robotronik/cdfr2023-base-roulante-carte-asservissment/Asservissement_CDFR_2023/Asservissement_CDFR_2023.kicad_pcb

## KiCad design Asservissement_CDFR_2023/Asservissement_CDFR_2023.kicad_pcb (2025-02-03)

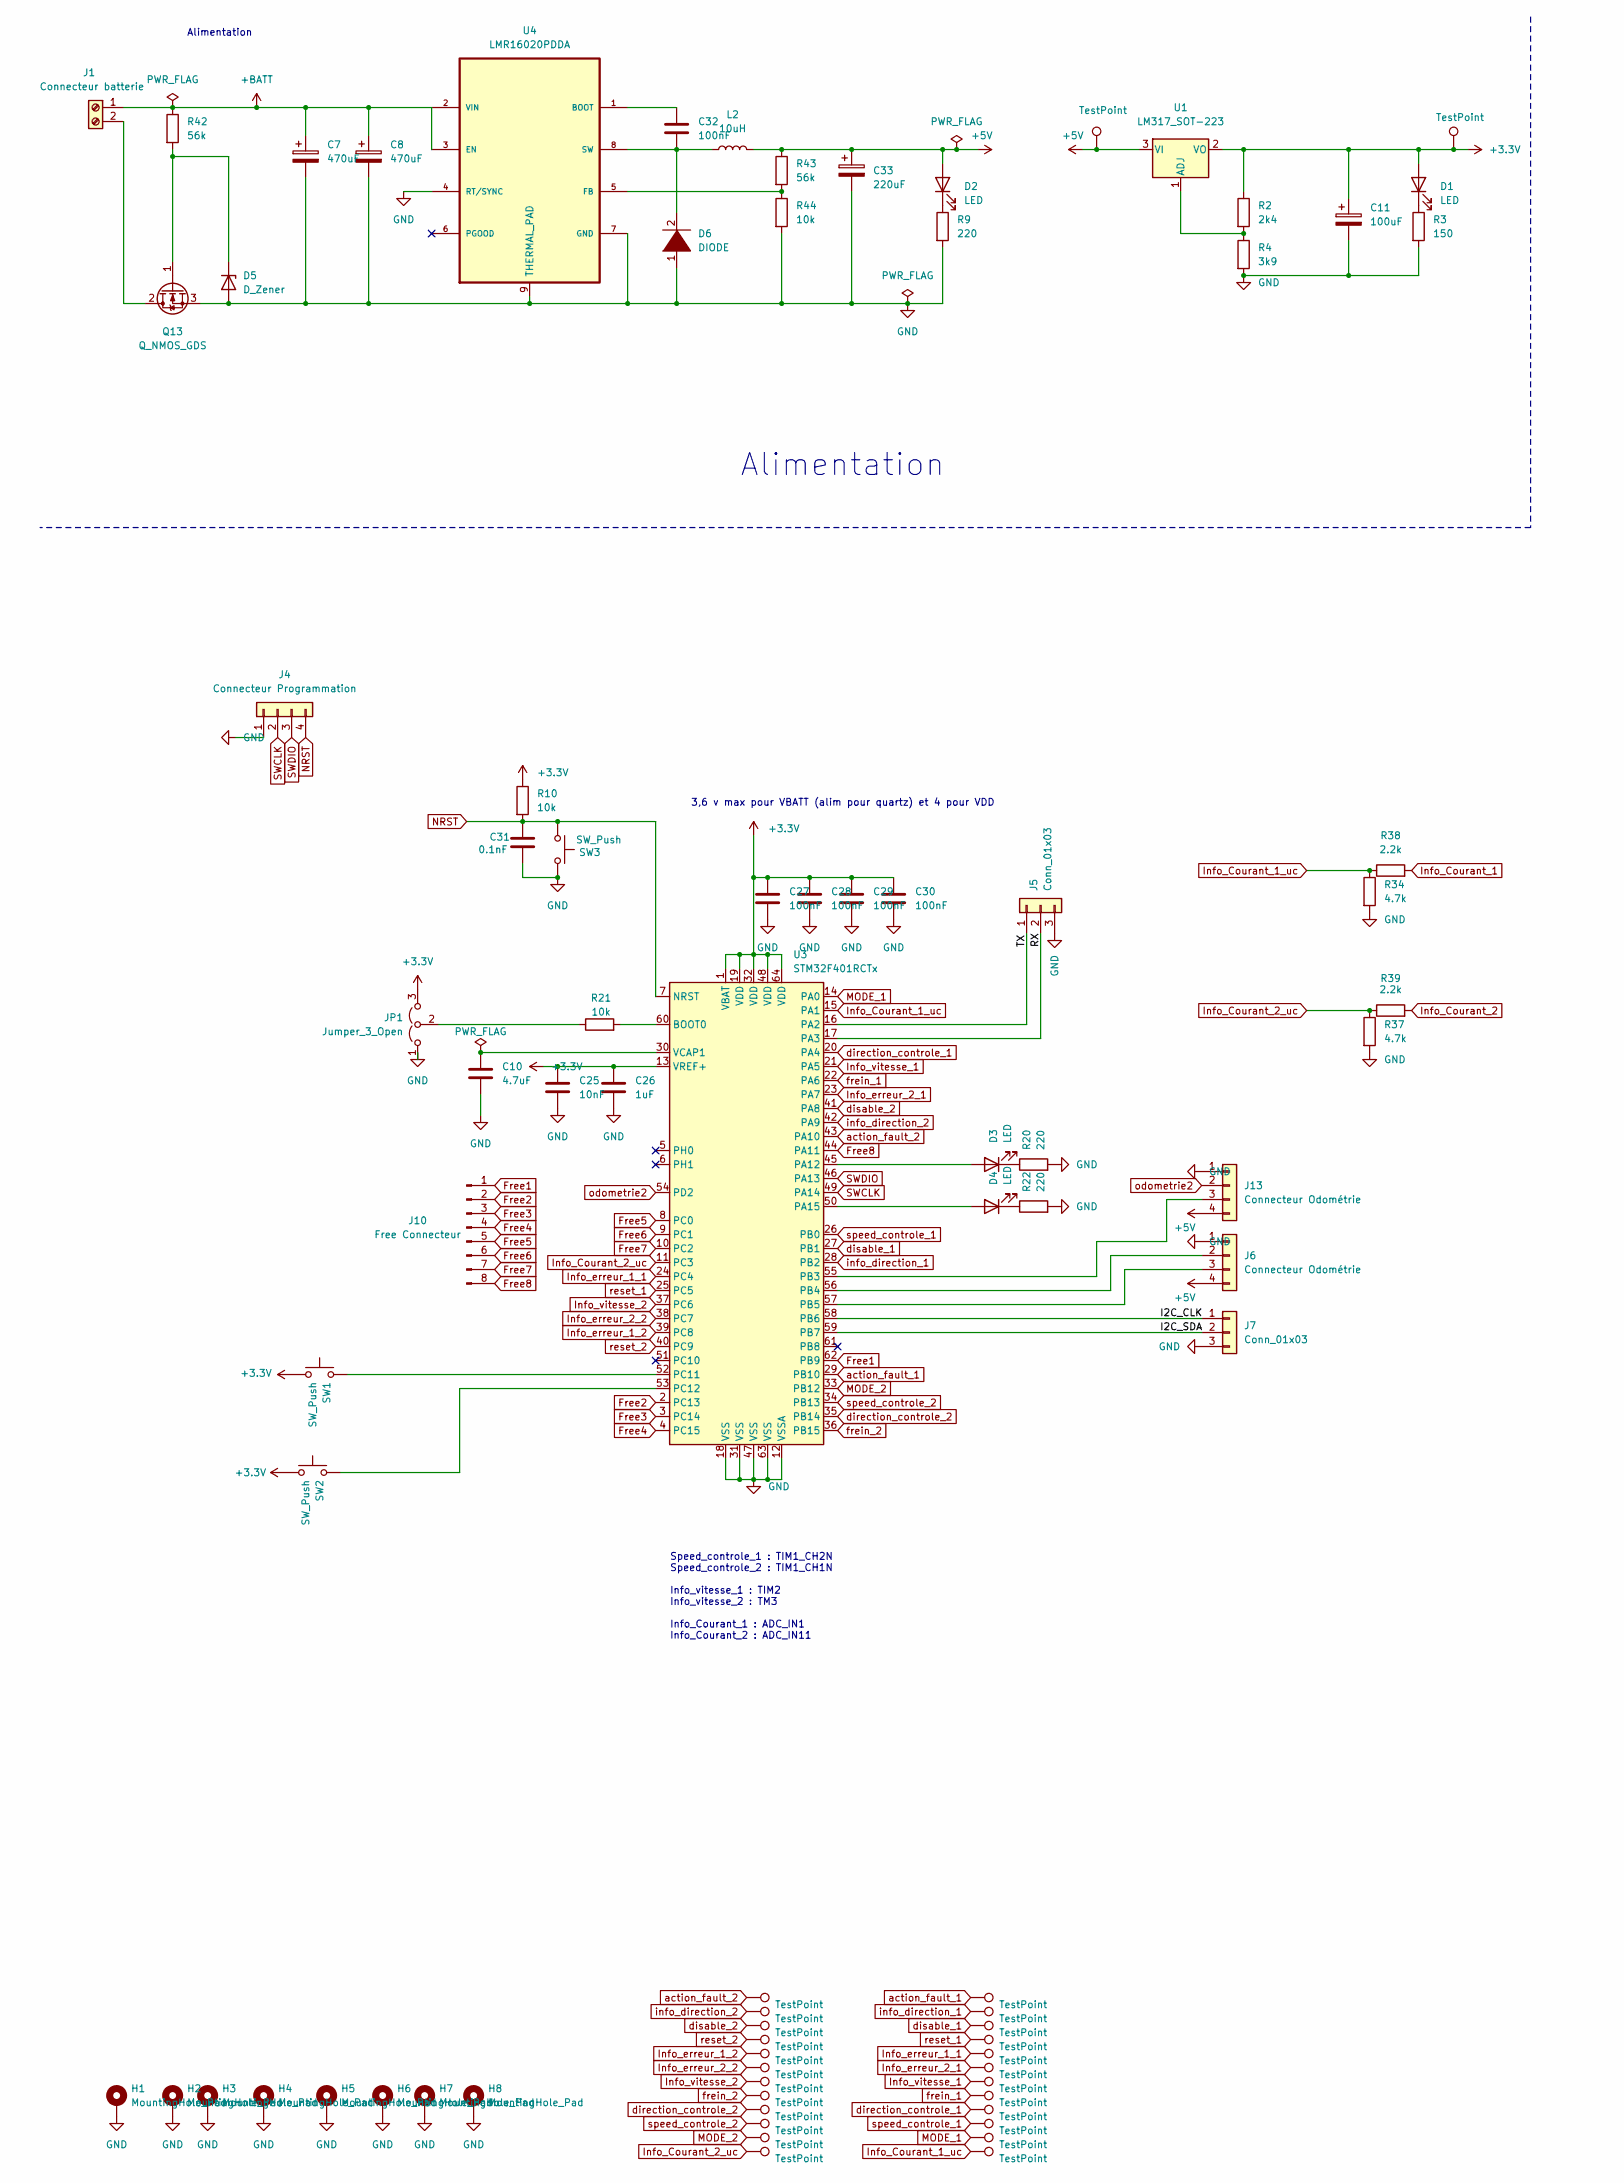
[picture p1: schematic Asservissement_CDFR_2023.kicad_sch, part in row 1, column 1]

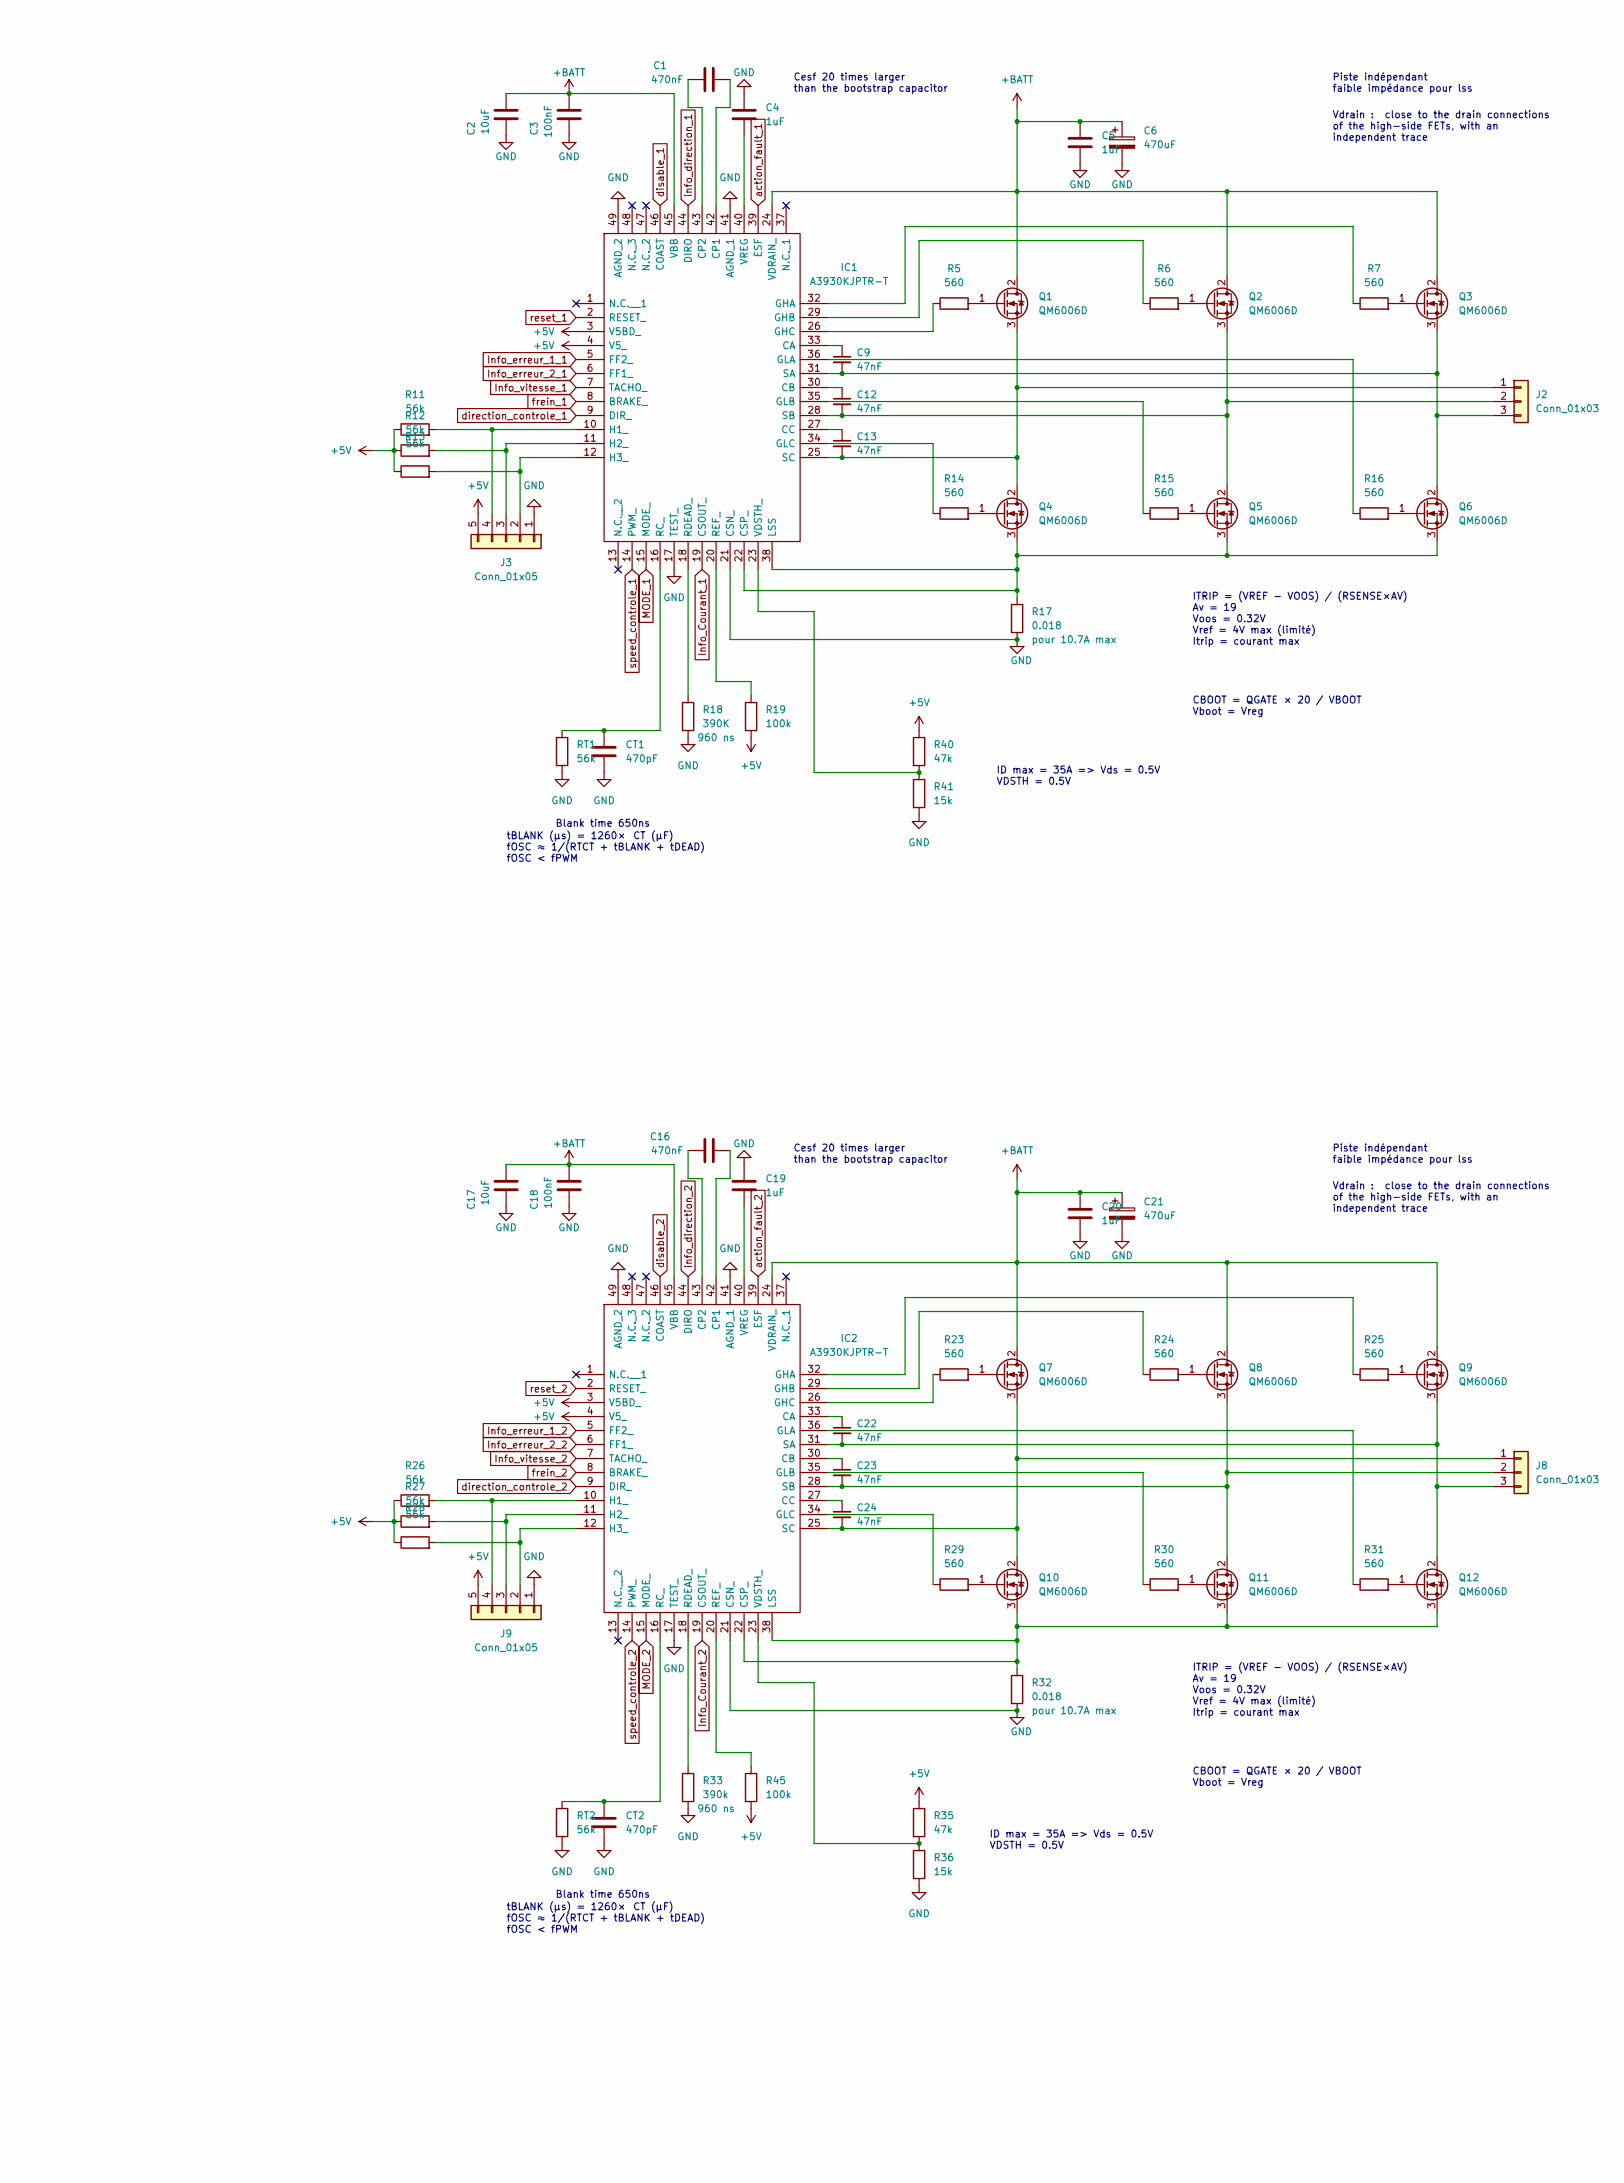
[picture p2: schematic Asservissement_CDFR_2023.kicad_sch, part in row 1, column 2]

Parts:
C1, C16: 470nF; C_0805_2012Metric_Pad1.18x1.45mm_HandSolder
C2, C17: 10uF; C_0805_2012Metric_Pad1.18x1.45mm_HandSolder
C3, C18, C27, C28, C29, C30, C32: 100nF; C_0805_2012Metric_Pad1.18x1.45mm_HandSolder
C4, C5, C19, C20, C26: 1uF; C_0805_2012Metric_Pad1.18x1.45mm_HandSolder
C6, C7, C8, C21: 470uF; CP_Elec_10x10.5
C9, C12, C13, C22, C23, C24: 47nF; C_0805_2012Metric_Pad1.18x1.45mm_HandSolder
C10: 4.7uF; C_0805_2012Metric_Pad1.18x1.45mm_HandSolder
C11: 100uF; CP_Elec_10x10.5
C25: 10nF; C_0805_2012Metric_Pad1.18x1.45mm_HandSolder
C31: 0.1nF; C_0805_2012Metric_Pad1.18x1.45mm_HandSolder
C33: 220uF; CP_Elec_10x10.5
CT1, CT2: 470pF; C_0805_2012Metric_Pad1.18x1.45mm_HandSolder
D1, D2, D3, D4: LED; LED_0805_2012Metric_Pad1.15x1.40mm_HandSolder
D5: D_Zener; D_SOD-123
D6: DIODE; DIOM505270X240
H1, H2, H3, H4: MountingHole_Pad; MountingHole_3.2mm_M3_Pad_Via
H5, H6, H7, H8: MountingHole_Pad; MountingHole_2.7mm_Pad_Via
IC1, IC2: A3930KJPTR-T; A3930KJPTRT; Manufacturer_Part_Number A3930KJPTR-T
J1: Connecteur batterie; CUI_TBP01R1-508-02BE
J2, J8: Conn_01x03; CUI_TBP02R1-381-03BE
J3, J9: Conn_01x05; JST_XH_B5B-XH-A_1x05_P2.50mm_Vertical
J4: Connecteur Programmation; PinHeader_1x04_P2.54mm_Vertical
J5: Conn_01x03; PinHeader_1x03_P2.54mm_Vertical
J6, J13: Connecteur Odométrie; JST_XH_B4B-XH-A_1x04_P2.50mm_Vertical
J7: Conn_01x03; JST_XH_B3B-XH-A_1x03_P2.50mm_Vertical
J10: Free Connecteur; PinHeader_1x08_P2.54mm_Vertical
JP1: Jumper_3_Open; PinHeader_1x03_P2.54mm_Vertical
L2: 10uH; IND_IHLP_2525_CZ-M
Q1, Q2, Q3, Q4, Q5, Q6, Q7, Q8, Q9, Q10, Q11, Q12: QM6006D; TO-252-2
Q13: Q_NMOS_GDS; TO-252-2
R2: 2k4; R_0805_2012Metric_Pad1.20x1.40mm_HandSolder
R3: 150; R_0805_2012Metric_Pad1.20x1.40mm_HandSolder
R4: 3k9; R_0805_2012Metric_Pad1.20x1.40mm_HandSolder
R5, R6, R7, R14, R15, R16, R23, R24, R25, R29, R30, R31: 560; R_0805_2012Metric_Pad1.20x1.40mm_HandSolder
R9, R20, R22: 220; R_0805_2012Metric_Pad1.20x1.40mm_HandSolder
R10, R21, R44: 10k; R_0805_2012Metric_Pad1.20x1.40mm_HandSolder
R11, R12, R13, R26, R27, R28, R42, R43: 56k; R_0805_2012Metric_Pad1.20x1.40mm_HandSolder
R17, R32: 0.018; R_2512_6332Metric
R18: 390K; R_0805_2012Metric_Pad1.20x1.40mm_HandSolder
R19, R45: 100k; R_0805_2012Metric_Pad1.20x1.40mm_HandSolder
R33: 390k; R_0805_2012Metric_Pad1.20x1.40mm_HandSolder
R34, R37: 4.7k; R_0805_2012Metric_Pad1.20x1.40mm_HandSolder
R35, R40: 47k; R_0805_2012Metric_Pad1.20x1.40mm_HandSolder
R36, R41: 15k; R_0805_2012Metric_Pad1.20x1.40mm_HandSolder
R38, R39: 2.2k; R_0805_2012Metric_Pad1.20x1.40mm_HandSolder
RT1, RT2: 56k; R_0805_2012Metric_Pad1.20x1.40mm_HandSolder
SW1, SW2, SW3: SW_Push; SW_PUSH_6mm_H5mm
TP1, TP2, TP3, TP4, TP5, TP6, TP7, TP8, TP9, TP10, TP11, TP12, TP13, TP14, TP25, TP26, TP27, TP28, TP29, TP30, TP31, TP32, TP33, TP34, TP35, TP36: TestPoint; TestPoint_Pad_D1.0mm
U1: LM317_SOT-223; SOT-223-3_TabPin2
U3: STM32F401RCTx; LQFP-64_10x10mm_P0.5mm
U4: LMR16020PDDA; SOIC-8-1EP_3.9x4.9mm_P1.27mm_EP2.41x3.3mm

Connections:
+3.3V: C11.1, C25.1, C26.1, C27.1, C28.1, C29.1, C30.1, D1.2 (A), JP1.3 (B), R2.1, R10.1, SW1.1, SW2.1, TP14.1, U1.2 (VO), U3.1 (VBAT), U3.13 (VREF+), U3.19 (VDD), U3.32 (VDD), U3.48 (VDD), U3.64 (VDD)
+5V: C33.1, D2.2 (A), IC1.3 (V5BD_), IC1.4 (V5_), IC2.3 (V5BD_), IC2.4 (V5_), J3.5, J6.4, J9.5, J13.4, L2.2, R11.1, R12.1, R13.1, R19.2, R26.1, R27.1, R28.1, R35.1, R40.1, R43.1, R45.2, TP13.1, U1.3 (VI)
+BATT: C2.1, C3.1, C5.1, C6.1, C7.1, C8.1, C17.1, C18.1, C20.1, C21.1, IC1.24 (VDRAIN_), IC1.45 (VBB), IC2.24 (VDRAIN_), IC2.45 (VBB), J1.1, Q1.2 (D), Q2.2 (D), Q3.2 (D), Q7.2 (D), Q8.2 (D), Q9.2 (D), R42.1, U4.2 (VIN), U4.3 (EN)
/I2C_CLK: J7.1, U3.58 (PB6)
/I2C_SDA: J7.2, U3.59 (PB7)
/RX: J5.2, U3.17 (PA3)
/TX: J5.1, U3.16 (PA2)
Free1: J10.1, U3.62 (PB9)
Free2: J10.2, U3.2 (PC13)
Free3: J10.3, U3.3 (PC14)
Free4: J10.4, U3.4 (PC15)
Free5: J10.5, U3.8 (PC0)
Free6: J10.6, U3.9 (PC1)
Free7: J10.7, U3.10 (PC2)
Free8: J10.8, U3.44 (PA11)
GND: C2.2, C3.2, C4.1, C5.2, C6.2, C7.2, C8.2, C10.2, C11.2, C17.2, C18.2, C19.1, C20.2, C21.2, C25.2, C26.2, C27.2, C28.2, C29.2, C30.2, C31.2, C33.2, CT1.2, CT2.2, D5.2 (A), D6.1 (K), H1.1, H2.1, H3.1, H4.1, H5.1, H6.1, H7.1, H8.1, IC1.17 (TEST_), IC1.21 (CSN_), IC1.41 (AGND_1), IC1.49 (AGND_2), IC2.17 (TEST_), IC2.21 (CSN_), IC2.41 (AGND_1), IC2.49 (AGND_2), J3.1, J4.1, J5.3, J6.1, J7.3, J9.1, J13.1, JP1.1 (A), Q13.3 (S), R3.2, R4.2, R9.2, R17.2, R18.2, R20.2, R22.2, R32.2, R33.2, R34.2, R36.2, R37.2, R41.2, R44.2, RT1.2, RT2.2, SW3.2, U3.12 (VSSA), U3.18 (VSS), U3.31 (VSS), U3.47 (VSS), U3.63 (VSS), U4.4 (RT/SYNC), U4.7 (GND), U4.9 (THERMAL_PAD)
Info_Courant_1: IC1.19 (CSOUT_), R38.2
Info_Courant_1_uc: R34.1, R38.1, TP36.1, U3.15 (PA1)
Info_Courant_2: IC2.19 (CSOUT_), R39.2
Info_Courant_2_uc: R37.1, R39.1, TP1.1, U3.11 (PC3)
Info_erreur_1_1: IC1.5 (FF2_), TP29.1, U3.24 (PC4)
Info_erreur_1_2: IC2.5 (FF2_), TP11.1, U3.39 (PC8)
Info_erreur_2_1: IC1.6 (FF1_), TP30.1, U3.23 (PA7)
Info_erreur_2_2: IC2.6 (FF1_), TP12.1, U3.38 (PC7)
Info_vitesse_1: IC1.7 (TACHO_), TP31.1, U3.21 (PA5)
Info_vitesse_2: IC2.7 (TACHO_), TP5.1, U3.37 (PC6)
MODE_1: IC1.15 (MODE_), TP35.1, U3.14 (PA0)
MODE_2: IC2.15 (MODE_), TP2.1, U3.33 (PB12)
NRST: C31.1, J4.4, R10.2, SW3.1, U3.7 (NRST)
unnamed: D1.1 (K), R3.1
unnamed: D2.1 (K), R9.1
unnamed: D3.2 (A), U3.45 (PA12)
unnamed: D3.1 (K), R20.1
unnamed: D4.2 (A), U3.50 (PA15)
unnamed: D4.1 (K), R22.1
unnamed: D5.1 (K), Q13.1 (G), R42.2
unnamed: C32.2, D6.2 (A), L2.1, U4.8 (SW)
unnamed: C9.1, IC1.33 (CA)
unnamed: C12.1, IC1.30 (CB)
unnamed: C13.1, IC1.27 (CC)
unnamed: C1.2, IC1.42 (CP1)
unnamed: C1.1, IC1.43 (CP2)
unnamed: IC1.22 (CSP_), IC1.38 (LSS), Q4.3 (S), Q5.3 (S), Q6.3 (S), R17.1
unnamed: IC1.32 (GHA), R7.1
unnamed: IC1.29 (GHB), R6.1
unnamed: IC1.26 (GHC), R5.1
unnamed: IC1.36 (GLA), R16.1
unnamed: IC1.35 (GLB), R15.1
unnamed: IC1.34 (GLC), R14.1
unnamed: IC1.10 (H1_), J3.4, R11.2
unnamed: IC1.11 (H2_), J3.3, R12.2
unnamed: IC1.12 (H3_), J3.2, R13.2
unnamed: CT1.1, IC1.16 (RC_), RT1.1
unnamed: IC1.18 (RDEAD_), R18.1
unnamed: IC1.20 (REF_), R19.1
unnamed: C9.2, IC1.31 (SA), J2.3, Q3.3 (S), Q6.2 (D)
unnamed: C12.2, IC1.28 (SB), J2.2, Q2.3 (S), Q5.2 (D)
unnamed: C13.2, IC1.25 (SC), J2.1, Q1.3 (S), Q4.2 (D)
unnamed: IC1.23 (VDSTH_), R40.2, R41.1
unnamed: C4.2, IC1.40 (VREG)
unnamed: C22.1, IC2.33 (CA)
unnamed: C23.1, IC2.30 (CB)
unnamed: C24.1, IC2.27 (CC)
unnamed: C16.2, IC2.42 (CP1)
unnamed: C16.1, IC2.43 (CP2)
unnamed: IC2.22 (CSP_), IC2.38 (LSS), Q10.3 (S), Q11.3 (S), Q12.3 (S), R32.1
unnamed: IC2.32 (GHA), R25.1
unnamed: IC2.29 (GHB), R24.1
unnamed: IC2.26 (GHC), R23.1
unnamed: IC2.36 (GLA), R31.1
unnamed: IC2.35 (GLB), R30.1
unnamed: IC2.34 (GLC), R29.1
unnamed: IC2.10 (H1_), J9.4, R26.2
unnamed: IC2.11 (H2_), J9.3, R27.2
unnamed: IC2.12 (H3_), J9.2, R28.2
unnamed: CT2.1, IC2.16 (RC_), RT2.1
unnamed: IC2.18 (RDEAD_), R33.1
unnamed: IC2.20 (REF_), R45.1
unnamed: C22.2, IC2.31 (SA), J8.3, Q9.3 (S), Q12.2 (D)
unnamed: C23.2, IC2.28 (SB), J8.2, Q8.3 (S), Q11.2 (D)
unnamed: C24.2, IC2.25 (SC), J8.1, Q7.3 (S), Q10.2 (D)
unnamed: IC2.23 (VDSTH_), R35.2, R36.1
unnamed: C19.2, IC2.40 (VREG)
unnamed: J1.2, Q13.2 (D)
unnamed: J6.2, U3.56 (PB4)
unnamed: J6.3, U3.57 (PB5)
unnamed: J13.3, U3.55 (PB3)
unnamed: JP1.2 (C), R21.1
unnamed: Q1.1 (G), R5.2
unnamed: Q2.1 (G), R6.2
unnamed: Q3.1 (G), R7.2
unnamed: Q4.1 (G), R14.2
unnamed: Q5.1 (G), R15.2
unnamed: Q6.1 (G), R16.2
unnamed: Q7.1 (G), R23.2
unnamed: Q8.1 (G), R24.2
unnamed: Q9.1 (G), R25.2
unnamed: Q10.1 (G), R29.2
unnamed: Q11.1 (G), R30.2
unnamed: Q12.1 (G), R31.2
unnamed: R2.2, R4.1, U1.1 (ADJ)
unnamed: R21.2, U3.60 (BOOT0)
unnamed: SW1.2, U3.52 (PC11)
unnamed: SW2.2, U3.53 (PC12)
unnamed: C10.1, U3.30 (VCAP1)
unnamed: C32.1, U4.1 (BOOT)
unnamed: R43.2, R44.1, U4.5 (FB)
SWCLK: J4.2, U3.49 (PA14)
SWDIO: J4.3, U3.46 (PA13)
action_fault_1: IC1.39 (ESF), TP25.1, U3.29 (PB10)
action_fault_2: IC2.39 (ESF), TP7.1, U3.43 (PA10)
direction_controle_1: IC1.9 (DIR_), TP33.1, U3.20 (PA4)
direction_controle_2: IC2.9 (DIR_), TP3.1, U3.35 (PB14)
disable_1: IC1.46 (COAST), TP27.1, U3.27 (PB1)
disable_2: IC2.46 (COAST), TP9.1, U3.41 (PA8)
frein_1: IC1.8 (BRAKE_), TP32.1, U3.22 (PA6)
frein_2: IC2.8 (BRAKE_), TP6.1, U3.36 (PB15)
info_direction_1: IC1.44 (DIRO), TP26.1, U3.28 (PB2)
info_direction_2: IC2.44 (DIRO), TP8.1, U3.42 (PA9)
odometrie2: J13.2, U3.54 (PD2)
reset_1: IC1.2 (RESET_), TP28.1, U3.25 (PC5)
reset_2: IC2.2 (RESET_), TP10.1, U3.40 (PC9)
speed_controle_1: IC1.14 (PWM_), TP34.1, U3.26 (PB0)
speed_controle_2: IC2.14 (PWM_), TP4.1, U3.34 (PB13)

Notes on the sheet:
tBLANK (µs) = 1260× CT (µF) fOSC ≈ 1/(RTCT + tBLANK + tDEAD) fOSC < fPWM
Blank time 650ns
Alimentation
ITRIP = (VREF - VOOS) / (RSENSE×AV) Av = 19 Voos = 0.32V Vref = 4V max (limité) Itrip = courant max
CBOOT = QGATE × 20 / VBOOT Vboot = Vreg
Speed_controle_1 : TIM1_CH2N Speed_controle_2 : TIM1_CH1N Info_vitesse_1 : TIM2 Info_vitesse_2 : TM3 Info_Courant_1 : ADC_IN1 Info_Courant_2 : ADC_IN11
ID max = 35A => Vds = 0.5V VDSTH = 0.5V
Vdrain : close to the drain connections of the high-side FETs, with an independent trace
Piste indépendant faible impédance pour lss
Cesf 20 times larger than the bootstrap capacitor
3,6 v max pour VBATT (alim pour quartz) et 4 pour VDD

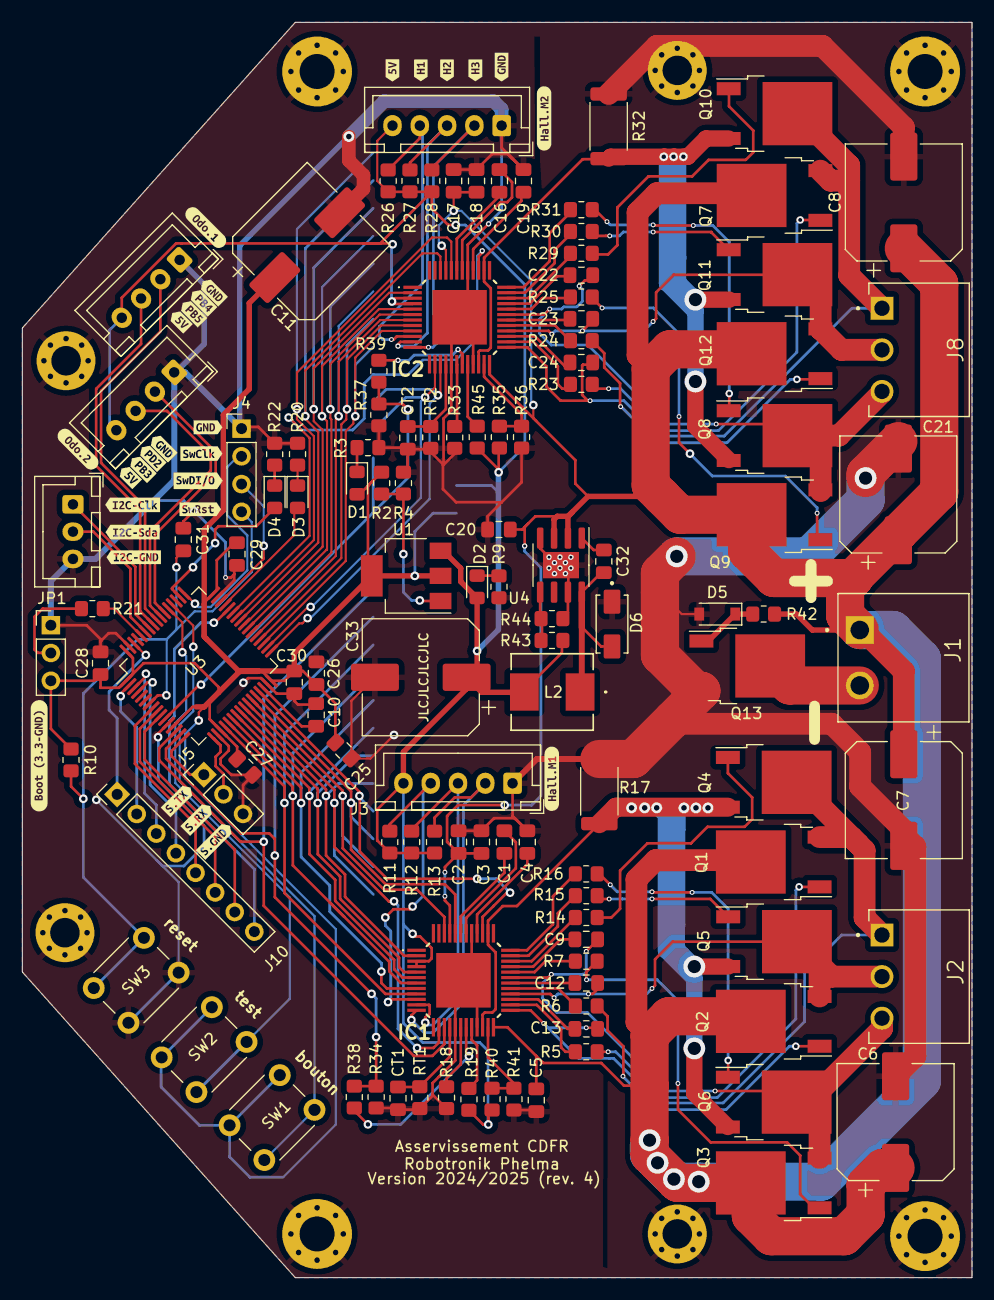
[picture p3: board Asservissement_CDFR_2023.kicad_pcb from above]

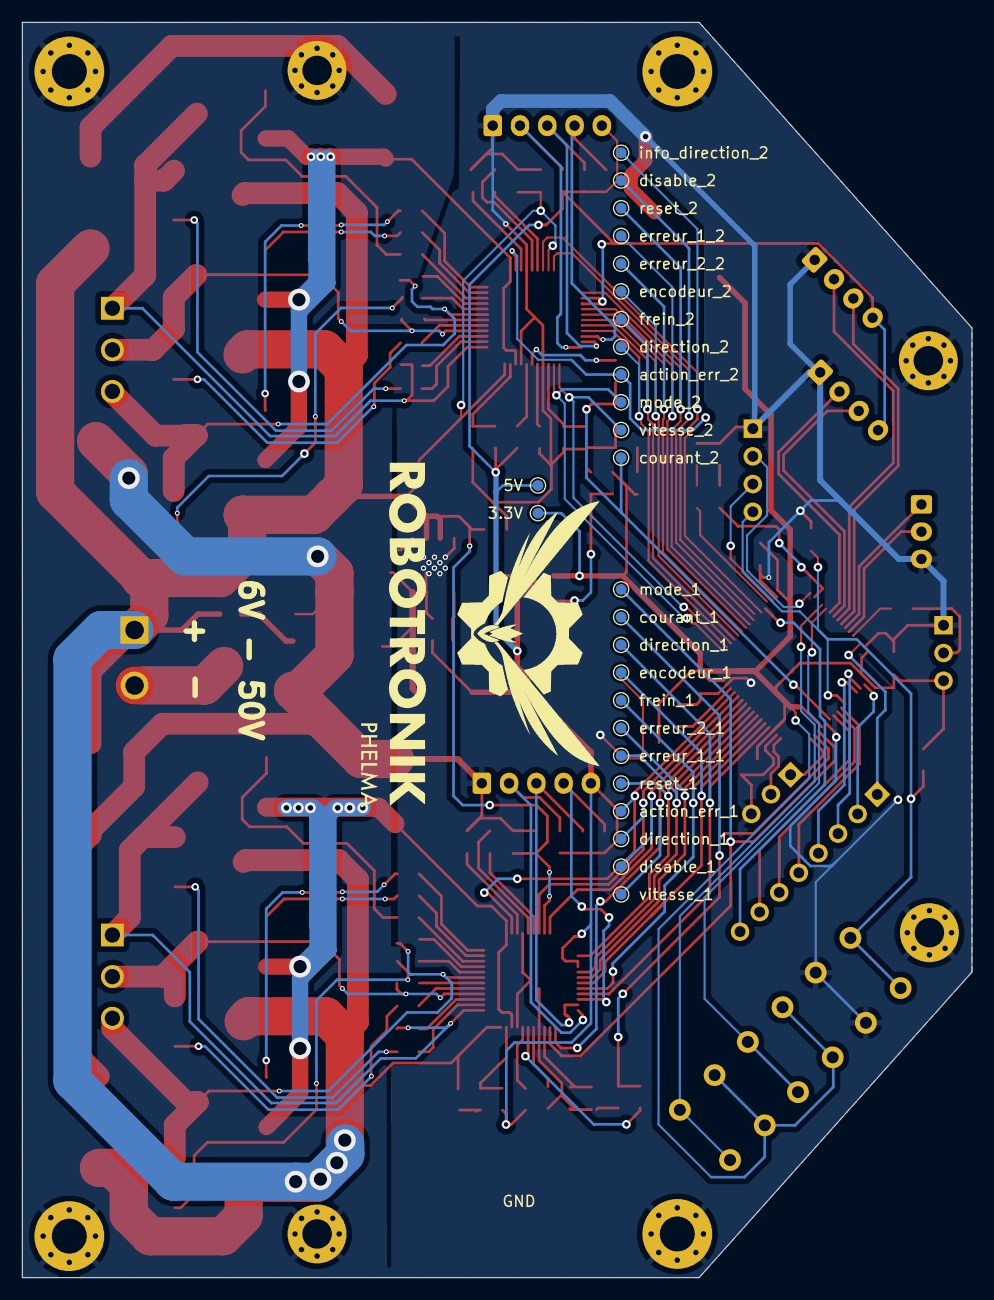
[picture p4: board Asservissement_CDFR_2023.kicad_pcb from below]

Board: 2 copper layers, 87.0 x 115.0 mm, 180 parts (26 on the bottom side), 124 nets.

Other parts of the board:
kibuzzard-637D41F7: G***; kibuzzard-637D41F7
kibuzzard-637D42B7: G***; kibuzzard-637D42B7
kibuzzard-637D42C2: G***; kibuzzard-637D42C2
kibuzzard-637D42CB: G***; kibuzzard-637D42CB
kibuzzard-637D42F0: G***; kibuzzard-637D42F0
kibuzzard-637D43BC: G***; kibuzzard-637D43BC
kibuzzard-637D43CD: G***; kibuzzard-637D43CD
kibuzzard-637D44C4: G***; kibuzzard-637D44C4
kibuzzard-637D44E0: G***; kibuzzard-637D44E0
kibuzzard-637D45A0: G***; kibuzzard-637D45A0
kibuzzard-637D428D: G***; kibuzzard-637D428D
kibuzzard-637D436E: G***; kibuzzard-637D436E
kibuzzard-637D437D: G***; kibuzzard-637D437D
kibuzzard-637D438C: G***; kibuzzard-637D438C
kibuzzard-637D4204: G***; kibuzzard-637D4204
kibuzzard-637D4217: G***; kibuzzard-637D4217
kibuzzard-637D4301: G***; kibuzzard-637D4301
kibuzzard-637D4322: G***; kibuzzard-637D4322
kibuzzard-637D4331: G***; kibuzzard-637D4331
kibuzzard-637D4374: G***; kibuzzard-637D4374
kibuzzard-637D4386: G***; kibuzzard-637D4386
kibuzzard-637D4446, kibuzzard-637D4446#2: G***; kibuzzard-637D4446
kibuzzard-637D4455: G***; kibuzzard-637D4455
kibuzzard-637D4463, kibuzzard-637D4463#2: G***; kibuzzard-637D4463
kibuzzard-637D4536: G***; kibuzzard-637D4536
kibuzzard-eD: G***; kibuzzard-637D447D
