robotronik/cdfr2023-base-roulante-carte-asservissment/(commit log)

2022-11-12 add one driver a3930
    [Asservissement_CDFR_2023.kicad_pcb, Asservissement_CDFR_2023.kicad_sch]
2022-11-13 Add files via upload
    Copie pour deuxième moteur
    [Asservissement CDFR 2023 .kicad_pcb, Asservissement CDFR 2023 .kicad_sch]
2022-11-16 driver set up
    [Asservissement CDFR 2023 .kicad_pcb, Asservissement CDFR 2023 .kicad_sch, Asservissement_CDFR_2023.kicad_pcb, Asservissement_CDFR_2023.kicad_sch]
2022-11-17 Maj de l'alimenter ok reste microcontrol
    [Asservissement_CDFR_2023.kicad_sch]
2022-11-18 Buck converter, fix gitignore
    [Asservissement_CDFR_2023.kicad_sch]
2022-11-18 NMOS reverse voltage protection
    [Asservissement_CDFR_2023.kicad_sch]
2022-11-19 schematic finished
    [Asservissement_CDFR_2023.kicad_pcb]
2022-11-21 Pré-routage carte asservissement (en attente de correctif sur l'ordre des pins du stm32)
    [Asservissement_CDFR_2023.kicad_pcb]
2022-11-21 uController modification pinout
    [Asservissement_CDFR_2023.kicad_pcb, Asservissement_CDFR_2023.kicad_sch]
2022-11-21 capacitor error
    [Asservissement_CDFR_2023.kicad_pcb, Asservissement_CDFR_2023.kicad_sch]
2022-11-22 Routing almost done
    [Asservissement_CDFR_2023.kicad_pcb, Asservissement_CDFR_2023.kicad_sch]
2022-11-24 Add files via upload
    Rounded corners
    [Asservissement_CDFR_2023.kicad_pcb]
2022-11-24 Fix Boost converter
    [Asservissement_CDFR_2023.kicad_pcb, Asservissement_CDFR_2023.kicad_sch]
2022-11-26 New buck routing + caps removal + fix ground on thermal pad for LMR16020 + removal of curved broder
    [Asservissement_CDFR_2023.kicad_pcb, Asservissement_CDFR_2023.kicad_sch]
2022-12-15 Carte pour nappe moteur 1.0
    [Carte nappe moteur.kicad_pcb, Carte nappe moteur.kicad_sch]
2023-01-30 chagement schemas
    [Asservissement_CDFR_2023.kicad_sch, Carte nappe moteur.kicad_pcb, Carte nappe moteur.kicad_sch]
2023-01-30 chagement composant
    [Asservissement_CDFR_2023.kicad_pcb, Asservissement_CDFR_2023.kicad_sch]
2023-01-31 routing updated to match new capacitors
    [Asservissement_CDFR_2023.kicad_pcb]
2023-02-14 add resistor for the crystal, add capacitor to Vcap, add logo and text for the voltage tolerance
    [Asservissement_CDFR_2023.kicad_pcb, Asservissement_CDFR_2023.kicad_sch]
2023-02-14 add name and version
    [Asservissement_CDFR_2023.kicad_pcb]
2023-02-15 add jlcjlcjlc
    [Asservissement_CDFR_2023.kicad_pcb]
2023-03-19 change one resistor
    [Asservissement_CDFR_2023.kicad_pcb, Asservissement_CDFR_2023.kicad_sch]
2025-02-03 V4 add button, test point, remove quartz, pot and fix current
    [Asservissement_CDFR_2023.kicad_pcb, Asservissement_CDFR_2023.kicad_sch]
